mokweri/EmbedUno/README.md

# EmbedUno

A clone of Arduino Uno designed using Altium Designer as a learning project for PCB design.

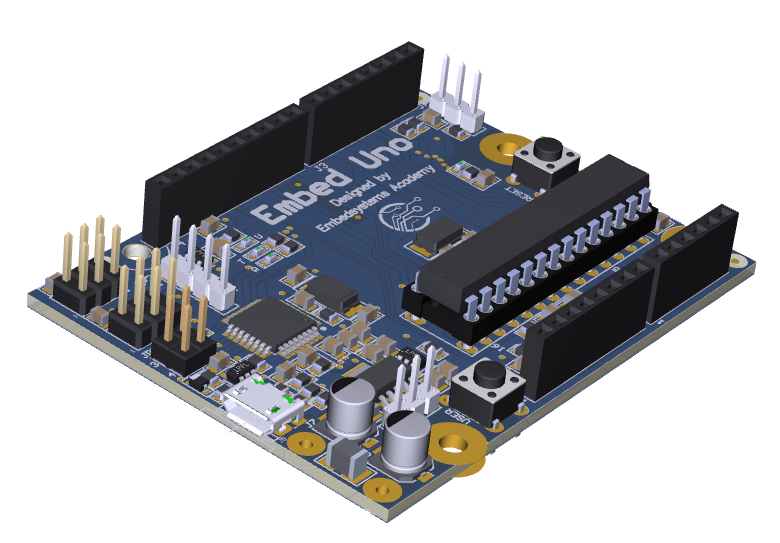
[picture p1: embeduno.PNG]


Designed in January 2020
