mokweri/EmbedUno/DesignFiles/EmbedUno_V1I1/embedsystems.png

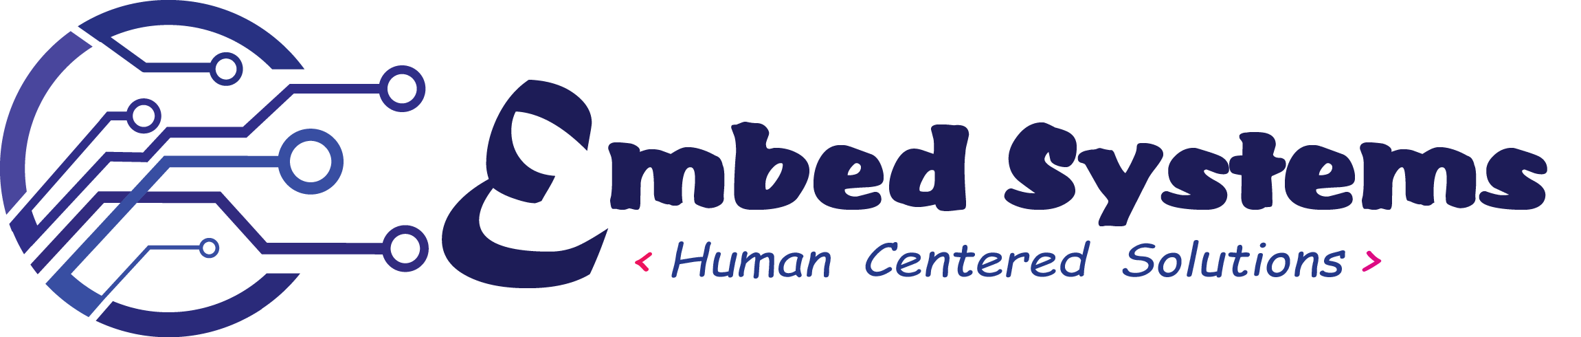
DesignFiles/EmbedUno_V1I1/embedsystems.png
