mokweri/EmbedUno/Fedevel Academy Cert.jpg

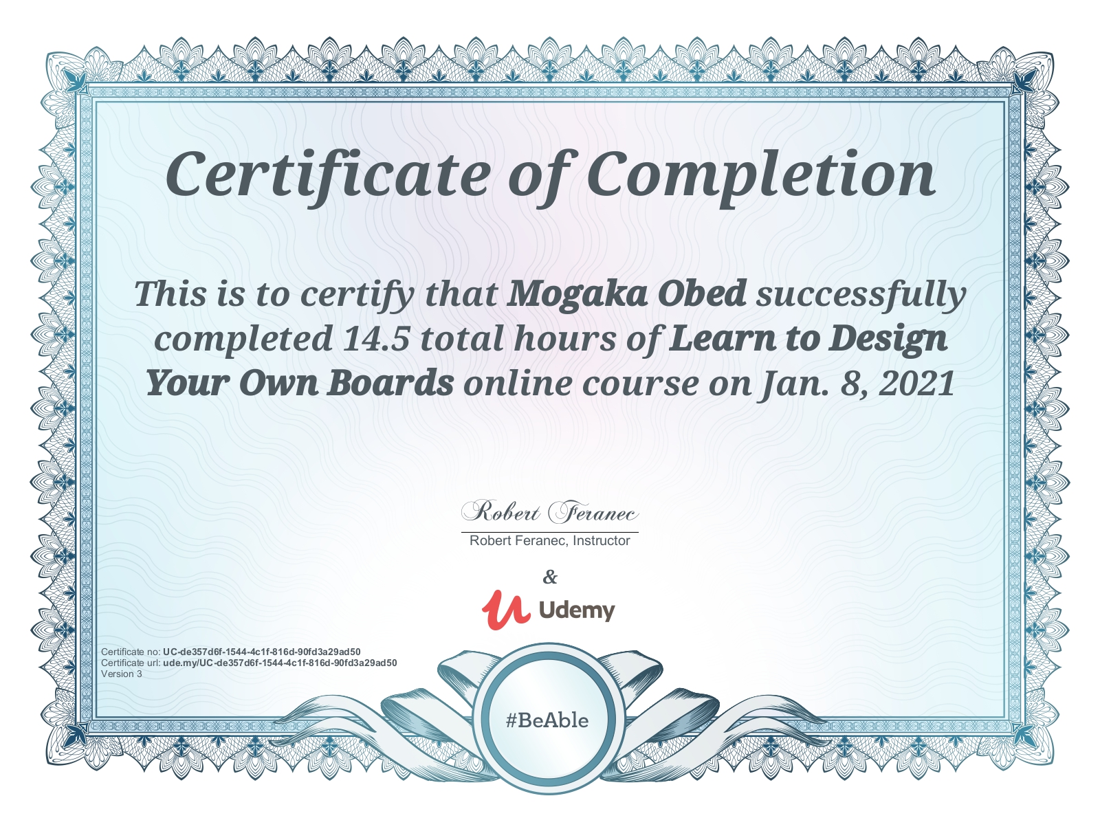
Fedevel Academy Cert.jpg
