mokweri/EmbedUno/!Released Files/Step 2 - Board Assembly/Variant 1 - EmbedUno V1I1 - Fixed 5V/BOM Purchasing - EmbedUno V1I1 - Fixed5V.xls

Sheet: Part List Report
 | Component list |  |  | EmbedUno BOM Purchasing for Variant [FIXED 5V] of Project [EmbedUno_V1I1.PrjPcb] (No PCB Document Selected)
 | Source Data From: | EmbedUno_V1I1.PrjPcb |  |  | Contact: |  |  |  | Generated by:
 | Project: | EmbedUno_V1I1.PrjPcb
 | Variant: | FIXED 5V |  |  |  |  |  |  | FEDEVEL
 | Report Date: | 08/01/2021 | 10:48 |  |  |  |  |  | http://www.fedevel.com
 | Print Date: | 2021-01-08 | 10:48:39
# | Category | Manufacturer 1 | Manufacturer Part Number 1 | #Column Name Error:' Package / Case | Description | Quantity | Supplier 1 | Supplier Part Number 1 | Supplier Order Qty 1 | Supplier Stock 1 | Supplier Unit Price 1 | Supplier Subtotal 1 | Supplier Currency 1
1 | Aluminum Electrolytic Capacitors | Panasonic | EEE-1AA101WR |  | Cap Aluminum 100uF 10V 20% (5 X 5.4mm) SMD 50mA 1000 hr 85°C T/R | 2 | Digi-Key | PCE3867CT-ND | 20 | 118060 | 0.24 | 4.86 | USD
2 | Ceramic Capacitors | TDK | C2012JB1E105K125AA |  | CAP CER 1UF 25V JB 0805 | 1 | Digi-Key | 445-11459-1-ND | 10 | 4257 | 0.14 | 1.39 | USD
3 | Ceramic Capacitors | TDK | C2012X5R1C106M085AC |  | TDK - C2012X5R1C106M085AC - SMD Multilayer Ceramic Capacitor, 10 µF, 16 V, 0805 [2012 Metric], ± 20%, X5R, C Series TDK | 7 | Digi-Key | 445-7645-1-ND | 70 | 160 | 0.11 | 7.97 | USD
4 | Ceramic Capacitors | KEMET | C0805C180J5GACTU |  | CAP CER 18PF 50V C0G/NP0 0805 | 4 | Digi-Key | 399-1112-1-ND | 40 | 98253 | 0.09 | 3.44 | USD
5 | Ceramic Capacitors | TDK | C2012X7R1H104M085AA |  | CAP CER 0.1UF 50V X7R 0805 | 19 | Digi-Key | 445-7535-1-ND | 190 | 7908 | 0.05 | 9.27 | USD
6 | Chip SMD Resistors | Yageo | RT0805FRE071KL |  | RES SMD 1K OHM 1% 1/8W 0805 | 3 | Digi-Key | YAG1240CT-ND | 30 | 45525 | 0.08 | 2.40 | USD
7 | Chip SMD Resistors | Yageo Phycomp | RC0805FR-071ML |  | RES SMD 1M OHM 1% 1/8W 0805 | 2 | Digi-Key | 311-1.00MCRCT-ND | 20 | 2401604 | 0.04 | 0.72 | USD
8 | Chip SMD Resistors | Yageo | AF0805FR-0710KL |  | Res SMD 10K Ohm 1% 1/8W 0805 | 6 | Digi-Key | 13-AF0805FR-0710KLCT-ND | 60 | 9580 | 0.09 | 5.16 | USD
9 | Chip SMD Resistors | Yageo | RC0805FR-0722RL |  | RES SMD 22 OHM 1% 1/8W 0805 | 7 | Digi-Key | 311-22.0CRCT-ND | 70 | 388180 | 0.04 | 2.52 | USD
10 | Chip SMD Resistors | Yageo | RT0805BRD07100KL |  | RES SMD 100K OHM 0.1% 1/8W 0805 | 1 | Digi-Key | YAG1759CT-ND | 10 | 6207 | 0.26 | 2.59 | USD
11 | Chip SMD Resistors | Yageo | RT0805FRE07560RL |  | RES SMD 560 OHM 1% 1/8W 0805 | 5 | Digi-Key | 13-RT0805FRE07560RLCT-ND | 50 | 9840 | 0.08 | 4.00 | USD
12 | Connectors | 3M | 4828-3004-CP |  | CONN IC DIP SOCKET 28POS TIN | 1 | Digi-Key | 3M5480-ND | 10 | 5 | 0.69 | 6.93 | USD
13 | Connectors | Sullins | QPC02SXGN-RC |  | CONN JUMPER SHORTING .100" GOLD | 2 | Digi-Key | S9337-ND | 20 | 698252 | 0.10 | 2.00 | USD
14 | Crystals | Abracon | ABM7-16.000MHZ-D2Y-T |  | CRYSTAL 16.0000MHZ 18PF SMD | 2 | Digi-Key | 535-9840-1-ND | 20 | 41060 | 0.77 | 15.46 | USD
15 | Ferrite Beads and Chips | TDK | MPZ2012S601AT000 |  | FERRITE BEAD 600 OHM 0805 1LN | 3 | Digi-Key | 445-2206-1-ND | 30 | 172425 | 0.08 | 2.47 | USD
16 | Fixed Inductors | KEMET | L1210R2R2MDWIT |  | FIXED IND 2.2UH 2A 80 MOHM SMD | 1 | Digi-Key | 399-9598-1-ND | 10 | 15053 | 0.42 | 4.17 | USD
17 | Headers and Wire Housings | Amphenol ICC | 68000-103HLF |  | HDR 1x3 | 1 | Digi-Key | 609-3461-ND | 10 | 21579 | 0.29 | 2.92 | USD
18 | Headers and Wire Housings | Amphenol FCI | 68001-204HLF |  | CONN HEADER VERT 4POS 2.54MM | 1 | Digi-Key | 609-3402-ND | 10 | 2119 | 0.36 | 3.57 | USD
19 | Headers and Wire Housings | Amphenol ICC / FCI | 67997-106HLF |  | CONN HEADER 6POS .100 STR 30AU | 2 | Digi-Key | 609-3393-ND | 20 | 1209 | 1.61 | 32.28 | USD
20 | Headers and Wire Housings | Harwin | M20-7820646 |  | HDR FEMALE 1x6 2.54mm | 1 | Digi-Key | 952-1809-ND | 10 | 1597 | 0.89 | 8.90 | USD
21 | Headers and Wire Housings | Harwin | M20-7820842 |  | 2.54mm (0.1") Pitch SIL Vertical PC Tail Socket Assembly, selective gold + tin, 8 contacts | 2 | Digi-Key | 952-1823-ND | 20 | 314 | 1.03 | 20.60 | USD
22 | Headers and Wire Housings | Harwin | M20-7821046 |  | HARWIN - M20-7821046 - Board-To-Board Connector, M20 Series, Through Hole, Receptacle, 10, 2.54 mm, Tin Plated Contacts | 1 | Digi-Key | 952-1847-ND | 10 | 645 | 1.00 | 9.97 | USD
23 | Logic Gates | Texas Instruments | SN74AHC1G09DBVR |  | TEXAS INSTRUMENTS - SN74AHC1G09DBVR - AND Gate, 74AHC1G09, 2 Input, 2 V to 5.5 V, SOT-23-5 | 4 | Digi-Key | 296-29202-1-ND | 40 | 14026 | 0.21 | 8.40 | USD
24 | Microcontrollers | Microchip / Atmel | ATMEGA16U2-AUR |  | IC MCU 8BIT 16KB FLASH 32TQFP | 1 | Digi-Key | ATMEGA16U2-AURCT-ND | 10 | 2980 | 2.52 | 25.20 | USD
25 | Microcontrollers | Microchip / Atmel | ATMEGA328P-PU |  | ATMEGA328P-PU; 8 bit Microcontroller AVR 20MHz 1; 32kb Flash; 2kb RAM; I2C SPI 2 | 1 | Digi-Key | ATMEGA328P-PU-ND | 10 | 9865 | 2.08 | 20.80 | USD
26 | Pushbutton Switches | ALCOSWITCH - TE CONNECTIVITY | 1825910-6 |  | SWITCH TACTILE SPST-NO 0.05A 24V | 2 | Digi-Key | 450-1650-ND | 20 | 131054 | 0.10 | 2.02 | USD
27 | Resistors | Yageo | RC0805JR-7W0RL |  | Resistor Thick Film Jumper 5% 0805 2-Pin Paper T/R | 2 | Digi-Key | 13-RC0805JR-7W0RLCT-ND | 20 | 3085 | 0.06 | 1.12 | USD
28 | Schottky Diodes | ON Semiconductor / Fairchild | BAT54HT1G |  | Small Signal Schottky Diode, Single, 30 V, 200 mA, 800 mV, 600 mA, 150 C ;RoHS Compliant: Yes | 2 | Digi-Key | BAT54HT1GOSCT-ND | 20 | 289270 | 0.14 | 2.82 | USD
29 | Uncategorized | Osram Opto | LGL29K-G2J1-24-Z |  | LED Uni-Color Green 572nm 2-Pin Chip 0603(1608Metric) T/R | 1 | Digi-Key | 475-2709-1-ND | 10 | 125735 | 0.31 | 3.08 | USD
30 | Uncategorized | Osram Opto | LOL29K-H2K1-24-Z |  | OSRAM - LO L29K-H2K1-24-Z - SMARTLED 0603 ORANGE | 3 | Digi-Key | 475-2740-2-ND |  | 0
31 | USB Connectors | AMPHENOL ICC (FCI) | 10118193-0001LF |  | CONN USB MICRO B RECPT SMT R/A | 1 | Digi-Key | 609-4616-1-ND | 10 | 42513 | 0.45 | 4.51 | USD
32 | Varistors | Bourns | CG0603MLC-05E |  | VARISTOR 0603 | 2 | Digi-Key | CG0603MLC-05ECT-ND | 20 | 110653 | 0.35 | 6.96 | USD
33 | Voltage Regulators - Linear | Texas Instruments | TL1963A-33DCQR |  | IC REG LINEAR 3.3V 1.5A SOT223-6 | 1 | Digi-Key | 296-24534-1-ND | 10 | 1730 | 2.51 | 25.13 | USD
 |  |  |  |  |  | 94 |  |  | 910 |  |  | 253.63
Approved |  |  |  | Notes
 |  |  |  |  |  | 10 | pcs: | Total |  | 253.63 |  | USD
 |  |  |  |  |  |  |  | Price for 1pcs |  | 25.36 |  | USD

Sheet: Project Information
Project Full Path | C:\Users\OBED\Documents\EmbedUno\DesignFiles\EmbedUno_V1I1\EmbedUno_V1I1.PrjPcb
Project Filename | EmbedUno_V1I1.PrjPcb
Variant Name | FIXED 5V
Data-Source Filename | EmbedUno_V1I1.PrjPcb
Data-Source Full Path | C:\Users\OBED\Documents\EmbedUno\DesignFiles\EmbedUno_V1I1\EmbedUno_V1I1.PrjPcb
Title | EmbedUno BOM Purchasing for Variant [FIXED 5V] of Project [EmbedUno_V1I1.PrjPcb] (No PCB Document Selected)
Total Quantity | 94
Report Time | 10:48
Report Date | 08/01/2021
Report Date & Tine | 08/01/2021 10:48
Output Name | EmbedUno BOM Purchasing
Output Type | BOM_PartType
Output Generator Name | BOM
Output Generator Description | Bill of Materials
