mokweri/EmbedUno/!Released Files/Step 2 - Board Assembly/Variant 1 - EmbedUno V1I1 - Fixed 5V/Componed Reference grouped BOM-EmbedUno_V1I1(FIXED 5V).xls

Sheet: Part List Report
 | Component reference list (grouped) |  |  |  | EmbedUno
 | Source Data From: |  | EmbedUno_V1I1.PrjPcb |  |  | Contact: |  | Generated by:
 | Project: |  | EmbedUno_V1I1.PrjPcb
 | Variant: |  | FIXED 5V |  |  |  |  | FEDEVEL
 | Report Date: |  | 08/01/2021 | 11:20 |  |  |  | http://www.fedevel.com
 | Print Date: |  | 2021-01-08 | 11:21:07
# | Designator | Quantity | Comment | Description | Manufacturer 1 | Manufacturer Part Number 1 | #Column Name Error:' Package / Case | Supplier 1 | Supplier Part Number 1
1 | C1, C2 | 2 | 100uF/10V | Cap Aluminum 100uF 10V 20% (5 X 5.4mm) SMD 50mA 1000 hr 85°C T/R |  |  |  | Digi-Key | PCE3867CT-ND
2 | C3, C12, C13, C19, C21, C22, C34 | 7 | 10uF/16V | TDK - C2012X5R1C106M085AC - SMD Multilayer Ceramic Capacitor, 10 µF, 16 V, 0805 [2012 Metric], ± 20%, X5R, C Series TDK |  |  |  | Digi-Key | 445-7645-1-ND
3 | C4, C5, C6, C8, C11, C14, C15, C16, C17, C20, C23, C24, C26, C28, C29, C30, C31, C32, C33 | 19 | 100n | CAP CER 0.1UF 50V X7R 0805 |  |  |  | Digi-Key | 445-7535-1-ND
4 | C7 | 1 | 1uF/25V | CAP CER 1UF 25V JB 0805 |  |  |  | Digi-Key | 445-11459-1-ND
5 | C9, C10, C25, C27 | 4 | 18p | CAP CER 18PF 50V C0G/NP0 0805 |  |  |  | Digi-Key | 399-1112-1-ND
6 | D1 | 1 | GREEN | LED Uni-Color Green 572nm 2-Pin Chip 0603(1608Metric) T/R |  |  |  | Digi-Key | 475-2709-1-ND
7 | D2, D3, D4 | 3 | Orange | OSRAM - LO L29K-H2K1-24-Z - SMARTLED 0603 ORANGE |  |  |  | Digi-Key | 475-2740-2-ND
8 | D5, D6 | 2 | BAT54HT1G | Small Signal Schottky Diode, Single, 30 V, 200 mA, 800 mV, 600 mA, 150 C ;RoHS Compliant: Yes |  |  |  | Digi-Key | BAT54HT1GOSCT-ND
9 | FB1, FB2, FB3 | 3 | MPZ2012S601AT000 | FERRITE BEAD 600 OHM 0805 1LN |  |  |  | Digi-Key | 445-2206-1-ND
10 | J1, J3 | 2 | HDR FEMALE 1x8 2.54mm | 2.54mm (0.1") Pitch SIL Vertical PC Tail Socket Assembly, selective gold + tin, 8 contacts |  |  |  | Digi-Key | 952-1823-ND
11 | J2 | 1 | HDR FEMALE 1x6 2.54mm | HDR FEMALE 1x6 2.54mm |  |  |  | Digi-Key | 952-1809-ND
12 | J4 | 1 | HDR FEMALE 1x10 2.54mm | HARWIN - M20-7821046 - Board-To-Board Connector, M20 Series, Through Hole, Receptacle, 10, 2.54 mm, Tin Plated Contacts |  |  |  | Digi-Key | 952-1847-ND
13 | J5, J6 | 2 | HDR 2x3 | CONN HEADER 6POS .100 STR 30AU |  |  |  | Digi-Key | 609-3393-ND
14 | J7 | 1 | 10118193-0001LF | CONN USB MICRO B RECPT SMT R/A |  |  |  | Digi-Key | 609-4616-1-ND
15 | JP1 | 1 | HDR 1x3 | HDR 1x3 |  |  |  | Digi-Key | 609-3461-ND
16 | JP3 | 1 | HDR 1x4 | CONN HEADER VERT 4POS 2.54MM |  |  |  | Digi-Key | 609-3402-ND
17 | L1 | 1 | 2u2/2A | FIXED IND 2.2UH 2A 80 MOHM SMD |  |  |  | Digi-Key | 399-9598-1-ND
18 | LINK1, LINK2 | 2 | LINK | CONN JUMPER SHORTING .100" GOLD |  |  |  | Digi-Key | S9337-ND
19 | R1 | 1 | 100K | RES SMD 100K OHM 0.1% 1/8W 0805 |  |  |  | Digi-Key | YAG1759CT-ND
20 | R2, R3, R15, R17, R22 | 5 | 560R | RES SMD 560 OHM 1% 1/8W 0805 |  |  |  | Digi-Key | 13-RT0805FRE07560RLCT-ND
21 | R4, R14, R18, R19, R20, R21 | 6 | 10K | Res SMD 10K Ohm 1% 1/8W 0805 |  |  |  | Digi-Key | 13-AF0805FR-0710KLCT-ND
22 | R5, R6, R7, R13, R23, R24, R25 | 7 | 22R | RES SMD 22 OHM 1% 1/8W 0805 |  |  |  | Digi-Key | 311-22.0CRCT-ND
23 | R8, R27 | 2 | 0R | Resistor Thick Film Jumper 5% 0805 2-Pin Paper T/R |  |  |  | Digi-Key | 13-RC0805JR-7W0RLCT-ND
24 | R9, R16 | 2 | 1M | RES SMD 1M OHM 1% 1/8W 0805 |  |  |  | Digi-Key | 311-1.00MCRCT-ND
25 | R10, R11, R12 | 3 | 1K | RES SMD 1K OHM 1% 1/8W 0805 |  |  |  | Digi-Key | YAG1240CT-ND
26 | SCK FOR U1 | 1 | 28-DIP Socket | CONN IC DIP SOCKET 28POS TIN |  |  |  | Digi-Key | 3M5480-ND
27 | SW1, SW2 | 2 | 1825910-6 | SWITCH TACTILE SPST-NO 0.05A 24V |  |  |  | Digi-Key | 450-1650-ND
28 | U1 | 1 | ATMEGA16U2-AUR | IC MCU 8BIT 16KB FLASH 32TQFP |  |  |  | Digi-Key | ATMEGA16U2-AURCT-ND
29 | U2 | 1 | TL1963A-33DCQR | IC REG LINEAR 3.3V 1.5A SOT223-6 |  |  |  | Digi-Key | 296-24534-1-ND
30 | U3 | 1 | ATMEGA328P-PU | ATMEGA328P-PU; 8 bit Microcontroller AVR 20MHz 1; 32kb Flash; 2kb RAM; I2C SPI 2 |  |  |  | Digi-Key | ATMEGA328P-PU-ND
31 | U4, U5, U6, U7 | 4 | SN74AHC1G09DBVR | TEXAS INSTRUMENTS - SN74AHC1G09DBVR - AND Gate, 74AHC1G09, 2 Input, 2 V to 5.5 V, SOT-23-5 |  |  |  | Digi-Key | 296-29202-1-ND
32 | Y1, Y2 | 2 | ABM7-16.000MHZ-D2Y-T | CRYSTAL 16.0000MHZ 18PF SMD |  |  |  | Digi-Key | 535-9840-1-ND
33 | Z1, Z2 | 2 | CG0603MLC-05E | VARISTOR 0603 |  |  |  | Digi-Key | CG0603MLC-05ECT-ND
Approved |  |  |  |  | Notes

Sheet: Project Information
Project Full Path | C:\Users\OBED\Documents\EmbedUno\DesignFiles\EmbedUno_V1I1\EmbedUno_V1I1.PrjPcb
Project Filename | EmbedUno_V1I1.PrjPcb
Variant Name | FIXED 5V
Data-Source Filename | EmbedUno_V1I1.PrjPcb
Data-Source Full Path | C:\Users\OBED\Documents\EmbedUno\DesignFiles\EmbedUno_V1I1\EmbedUno_V1I1.PrjPcb
Title | EmbedUno_V1I1.PrjPcb
Total Quantity | 94
Report Time | 11:20
Report Date | 08/01/2021
Report Date & Tine | 08/01/2021 11:20
Output Name | Embeduno Componed Reference grouped BOM
Output Type | BOM_PartType
Output Generator Name | BOM
Output Generator Description | Bill of Materials
