mokweri/EmbedUno/!Released Files/Step 2 - Board Assembly/Variant 2 - EmbedUno V1I1 - 5V and 3V3/BOM Reference - EmbedUno_V1I1(5V_3V3).xlsx

Sheet: Part List Report
 | Component reference list |  |  | EmbedUno
 |  | Source Data From: | EmbedUno_V1I1.PrjPcb |  | Contact: |  | Generated by:
 |  | Project: | EmbedUno_V1I1.PrjPcb
 |  | Variant: | 5V/3V3 |  |  |  | FEDEVEL
 | Report Date: | 08/01/2021 | 11:09 |  |  |  | http://www.fedevel.com
 | Print Date: | 2021-01-08 | 11:09:59
# | Designator | Comment | Description | Manufacturer 1 | Manufacturer Part Number 1 | Case/Package | Supplier 1 | Supplier Part Number 1
1 | C1 | 100uF/10V | Cap Aluminum 100uF 10V 20% (5 X 5.4mm) SMD 50mA 1000 hr 85°C T/R |  |  | Radial | Digi-Key | PCE3867CT-ND
2 | C2 | 100uF/10V | Cap Aluminum 100uF 10V 20% (5 X 5.4mm) SMD 50mA 1000 hr 85°C T/R |  |  | Radial | Digi-Key | PCE3867CT-ND
3 | C3 | 10uF/16V | TDK - C2012X5R1C106M085AC - SMD Multilayer Ceramic Capacitor, 10 µF, 16 V, 0805 [2012 Metric], ± 20%, X5R, C Series TDK |  |  | 805 | Digi-Key | 445-7645-1-ND
4 | C4 | 100n | CAP CER 0.1UF 50V X7R 0805 |  |  | 805 | Digi-Key | 445-7535-1-ND
5 | C5 | 100n | CAP CER 0.1UF 50V X7R 0805 |  |  | 805 | Digi-Key | 445-7535-1-ND
6 | C6 | 100n | CAP CER 0.1UF 50V X7R 0805 |  |  | 805 | Digi-Key | 445-7535-1-ND
7 | C7 | 1uF/25V | CAP CER 1UF 25V JB 0805 |  |  | 805 | Digi-Key | 445-11459-1-ND
8 | C8 | 100n | CAP CER 0.1UF 50V X7R 0805 |  |  | 805 | Digi-Key | 445-7535-1-ND
9 | C9 | 18p | CAP CER 18PF 50V C0G/NP0 0805 |  |  | 805 | Digi-Key | 399-1112-1-ND
10 | C10 | 18p | CAP CER 18PF 50V C0G/NP0 0805 |  |  | 805 | Digi-Key | 399-1112-1-ND
11 | C11 | 100n | CAP CER 0.1UF 50V X7R 0805 |  |  | 805 | Digi-Key | 445-7535-1-ND
12 | C12 | 10uF/16V | TDK - C2012X5R1C106M085AC - SMD Multilayer Ceramic Capacitor, 10 µF, 16 V, 0805 [2012 Metric], ± 20%, X5R, C Series TDK |  |  | 805 | Digi-Key | 445-7645-1-ND
13 | C13 | 10uF/16V | TDK - C2012X5R1C106M085AC - SMD Multilayer Ceramic Capacitor, 10 µF, 16 V, 0805 [2012 Metric], ± 20%, X5R, C Series TDK |  |  | 805 | Digi-Key | 445-7645-1-ND
14 | C14 | 100n | CAP CER 0.1UF 50V X7R 0805 |  |  | 805 | Digi-Key | 445-7535-1-ND
15 | C15 | 100n | CAP CER 0.1UF 50V X7R 0805 |  |  | 805 | Digi-Key | 445-7535-1-ND
16 | C16 | 100n | CAP CER 0.1UF 50V X7R 0805 |  |  | 805 | Digi-Key | 445-7535-1-ND
17 | C17 | 100n | CAP CER 0.1UF 50V X7R 0805 |  |  | 805 | Digi-Key | 445-7535-1-ND
18 | C19 | 10uF/16V | TDK - C2012X5R1C106M085AC - SMD Multilayer Ceramic Capacitor, 10 µF, 16 V, 0805 [2012 Metric], ± 20%, X5R, C Series TDK |  |  | 805 | Digi-Key | 445-7645-1-ND
19 | C20 | 100n | CAP CER 0.1UF 50V X7R 0805 |  |  | 805 | Digi-Key | 445-7535-1-ND
20 | C21 | 10uF/16V | TDK - C2012X5R1C106M085AC - SMD Multilayer Ceramic Capacitor, 10 µF, 16 V, 0805 [2012 Metric], ± 20%, X5R, C Series TDK |  |  | 805 | Digi-Key | 445-7645-1-ND
21 | C22 | 10uF/16V | TDK - C2012X5R1C106M085AC - SMD Multilayer Ceramic Capacitor, 10 µF, 16 V, 0805 [2012 Metric], ± 20%, X5R, C Series TDK |  |  | 805 | Digi-Key | 445-7645-1-ND
22 | C23 | 100n | CAP CER 0.1UF 50V X7R 0805 |  |  | 805 | Digi-Key | 445-7535-1-ND
23 | C24 | 100n | CAP CER 0.1UF 50V X7R 0805 |  |  | 805 | Digi-Key | 445-7535-1-ND
24 | C25 | 18p | CAP CER 18PF 50V C0G/NP0 0805 |  |  | 805 | Digi-Key | 399-1112-1-ND
25 | C26 | 100n | CAP CER 0.1UF 50V X7R 0805 |  |  | 805 | Digi-Key | 445-7535-1-ND
26 | C27 | 18p | CAP CER 18PF 50V C0G/NP0 0805 |  |  | 805 | Digi-Key | 399-1112-1-ND
27 | C28 | 100n | CAP CER 0.1UF 50V X7R 0805 |  |  | 805 | Digi-Key | 445-7535-1-ND
28 | C29 | 100n | CAP CER 0.1UF 50V X7R 0805 |  |  | 805 | Digi-Key | 445-7535-1-ND
29 | C30 | 100n | CAP CER 0.1UF 50V X7R 0805 |  |  | 805 | Digi-Key | 445-7535-1-ND
30 | C31 | 100n | CAP CER 0.1UF 50V X7R 0805 |  |  | 805 | Digi-Key | 445-7535-1-ND
31 | C32 | 100n | CAP CER 0.1UF 50V X7R 0805 |  |  | 805 | Digi-Key | 445-7535-1-ND
32 | C33 | 100n | CAP CER 0.1UF 50V X7R 0805 |  |  | 805 | Digi-Key | 445-7535-1-ND
33 | C34 | 10uF/16V | TDK - C2012X5R1C106M085AC - SMD Multilayer Ceramic Capacitor, 10 µF, 16 V, 0805 [2012 Metric], ± 20%, X5R, C Series TDK |  |  | 805 | Digi-Key | 445-7645-1-ND
34 | D1 | GREEN | LED Uni-Color Green 572nm 2-Pin Chip 0603(1608Metric) T/R |  |  | 603 | Digi-Key | 475-2709-1-ND
35 | D2 | Orange | OSRAM - LO L29K-H2K1-24-Z - SMARTLED 0603 ORANGE |  |  | 603 | Digi-Key | 475-2740-2-ND
36 | D3 | Orange | OSRAM - LO L29K-H2K1-24-Z - SMARTLED 0603 ORANGE |  |  | 603 | Digi-Key | 475-2740-2-ND
37 | D4 | Orange | OSRAM - LO L29K-H2K1-24-Z - SMARTLED 0603 ORANGE |  |  | 603 | Digi-Key | 475-2740-2-ND
38 | D5 | BAT54HT1G | Small Signal Schottky Diode, Single, 30 V, 200 mA, 800 mV, 600 mA, 150 C ;RoHS Compliant: Yes |  |  |  | Digi-Key | BAT54HT1GOSCT-ND
39 | D6 | BAT54HT1G | Small Signal Schottky Diode, Single, 30 V, 200 mA, 800 mV, 600 mA, 150 C ;RoHS Compliant: Yes |  |  |  | Digi-Key | BAT54HT1GOSCT-ND
40 | FB1 | MPZ2012S601AT000 | FERRITE BEAD 600 OHM 0805 1LN |  |  | 805 | Digi-Key | 445-2206-1-ND
41 | FB2 | MPZ2012S601AT000 | FERRITE BEAD 600 OHM 0805 1LN |  |  | 805 | Digi-Key | 445-2206-1-ND
42 | FB3 | MPZ2012S601AT000 | FERRITE BEAD 600 OHM 0805 1LN |  |  | 805 | Digi-Key | 445-2206-1-ND
43 | J1 | HDR FEMALE 1x8 2.54mm | 2.54mm (0.1") Pitch SIL Vertical PC Tail Socket Assembly, selective gold + tin, 8 contacts |  |  | SIL | Digi-Key | 952-1823-ND
44 | J2 | HDR FEMALE 1x6 2.54mm | HDR FEMALE 1x6 2.54mm |  |  | SIL | Digi-Key | 952-1809-ND
45 | J3 | HDR FEMALE 1x8 2.54mm | 2.54mm (0.1") Pitch SIL Vertical PC Tail Socket Assembly, selective gold + tin, 8 contacts |  |  | SIL | Digi-Key | 952-1823-ND
46 | J4 | HDR FEMALE 1x10 2.54mm | HARWIN - M20-7821046 - Board-To-Board Connector, M20 Series, Through Hole, Receptacle, 10, 2.54 mm, Tin Plated Contacts |  |  | SIL | Digi-Key | 952-1847-ND
47 | J5 | HDR 2x3 | CONN HEADER 6POS .100 STR 30AU |  |  |  | Digi-Key | 609-3393-ND
48 | J6 | HDR 2x3 | CONN HEADER 6POS .100 STR 30AU |  |  |  | Digi-Key | 609-3393-ND
49 | J7 | 10118193-0001LF | CONN USB MICRO B RECPT SMT R/A |  |  |  | Digi-Key | 609-4616-1-ND
50 | JP1 | HDR 1x3 | HDR 1x3 |  |  |  | Digi-Key | 609-3461-ND
51 | JP3 | HDR 1x4 | CONN HEADER VERT 4POS 2.54MM |  |  |  | Digi-Key | 609-3402-ND
52 | JP4 | HDR 1x3 | HDR 1x3 |  |  |  | Digi-Key | 609-3461-ND
53 | L1 | 2u2/2A | FIXED IND 2.2UH 2A 80 MOHM SMD |  |  | 1210 | Digi-Key | 399-9598-1-ND
54 | LINK1 | LINK | CONN JUMPER SHORTING .100" GOLD |  |  | 100 | Digi-Key | S9337-ND
55 | LINK2 | LINK | CONN JUMPER SHORTING .100" GOLD |  |  | 100 | Digi-Key | S9337-ND
56 | LINK3 | LINK | CONN JUMPER SHORTING .100" GOLD |  |  | 100 | Digi-Key | S9337-ND
57 | R1 | 100K | RES SMD 100K OHM 0.1% 1/8W 0805 |  |  | 805 | Digi-Key | YAG1759CT-ND
58 | R2 | 560R | RES SMD 560 OHM 1% 1/8W 0805 |  |  | 805 | Digi-Key | 13-RT0805FRE07560RLCT-ND
59 | R3 | 560R | RES SMD 560 OHM 1% 1/8W 0805 |  |  | 805 | Digi-Key | 13-RT0805FRE07560RLCT-ND
60 | R4 | 10K | Res SMD 10K Ohm 1% 1/8W 0805 |  |  | 805 | Digi-Key | 13-AF0805FR-0710KLCT-ND
61 | R5 | 22R | RES SMD 22 OHM 1% 1/8W 0805 |  |  | 805 | Digi-Key | 311-22.0CRCT-ND
62 | R6 | 22R | RES SMD 22 OHM 1% 1/8W 0805 |  |  | 805 | Digi-Key | 311-22.0CRCT-ND
63 | R7 | 22R | RES SMD 22 OHM 1% 1/8W 0805 |  |  | 805 | Digi-Key | 311-22.0CRCT-ND
64 | R8 | 0R | Resistor Thick Film Jumper 5% 0805 2-Pin Paper T/R |  |  |  | Digi-Key | 13-RC0805JR-7W0RLCT-ND
65 | R9 | 1M | RES SMD 1M OHM 1% 1/8W 0805 |  |  | 805 | Digi-Key | 311-1.00MCRCT-ND
66 | R10 | 1K | RES SMD 1K OHM 1% 1/8W 0805 |  |  | 805 | Digi-Key | YAG1240CT-ND
67 | R11 | 1K | RES SMD 1K OHM 1% 1/8W 0805 |  |  | 805 | Digi-Key | YAG1240CT-ND
68 | R12 | 1K | RES SMD 1K OHM 1% 1/8W 0805 |  |  | 805 | Digi-Key | YAG1240CT-ND
69 | R13 | 22R | RES SMD 22 OHM 1% 1/8W 0805 |  |  | 805 | Digi-Key | 311-22.0CRCT-ND
70 | R14 | 10K | Res SMD 10K Ohm 1% 1/8W 0805 |  |  | 805 | Digi-Key | 13-AF0805FR-0710KLCT-ND
71 | R15 | 560R | RES SMD 560 OHM 1% 1/8W 0805 |  |  | 805 | Digi-Key | 13-RT0805FRE07560RLCT-ND
72 | R16 | 1M | RES SMD 1M OHM 1% 1/8W 0805 |  |  | 805 | Digi-Key | 311-1.00MCRCT-ND
73 | R17 | 560R | RES SMD 560 OHM 1% 1/8W 0805 |  |  | 805 | Digi-Key | 13-RT0805FRE07560RLCT-ND
74 | R18 | 10K | Res SMD 10K Ohm 1% 1/8W 0805 |  |  | 805 | Digi-Key | 13-AF0805FR-0710KLCT-ND
75 | R19 | 10K | Res SMD 10K Ohm 1% 1/8W 0805 |  |  | 805 | Digi-Key | 13-AF0805FR-0710KLCT-ND
76 | R20 | 10K | Res SMD 10K Ohm 1% 1/8W 0805 |  |  | 805 | Digi-Key | 13-AF0805FR-0710KLCT-ND
77 | R21 | 10K | Res SMD 10K Ohm 1% 1/8W 0805 |  |  | 805 | Digi-Key | 13-AF0805FR-0710KLCT-ND
78 | R22 | 560R | RES SMD 560 OHM 1% 1/8W 0805 |  |  | 805 | Digi-Key | 13-RT0805FRE07560RLCT-ND
79 | R23 | 22R | RES SMD 22 OHM 1% 1/8W 0805 |  |  | 805 | Digi-Key | 311-22.0CRCT-ND
80 | R24 | 22R | RES SMD 22 OHM 1% 1/8W 0805 |  |  | 805 | Digi-Key | 311-22.0CRCT-ND
81 | R25 | 22R | RES SMD 22 OHM 1% 1/8W 0805 |  |  | 805 | Digi-Key | 311-22.0CRCT-ND
82 | SCK FOR U1 | 28-DIP Socket | CONN IC DIP SOCKET 28POS TIN |  |  |  | Digi-Key | 3M5480-ND
83 | SW1 | 1825910-6 | SWITCH TACTILE SPST-NO 0.05A 24V |  |  |  | Digi-Key | 450-1650-ND
84 | SW2 | 1825910-6 | SWITCH TACTILE SPST-NO 0.05A 24V |  |  |  | Digi-Key | 450-1650-ND
85 | U1 | ATMEGA16U2-AUR | IC MCU 8BIT 16KB FLASH 32TQFP |  |  | LQFP | Digi-Key | ATMEGA16U2-AURCT-ND
86 | U2 | TL1963A-33DCQR | IC REG LINEAR 3.3V 1.5A SOT223-6 |  |  | SOT-223 | Digi-Key | 296-24534-1-ND
87 | U3 | ATMEGA328P-PU | ATMEGA328P-PU; 8 bit Microcontroller AVR 20MHz 1; 32kb Flash; 2kb RAM; I2C SPI 2 |  |  | PDIP | Digi-Key | ATMEGA328P-PU-ND
88 | U4 | SN74AHC1G09DBVR | TEXAS INSTRUMENTS - SN74AHC1G09DBVR - AND Gate, 74AHC1G09, 2 Input, 2 V to 5.5 V, SOT-23-5 |  |  | SOT-23 | Digi-Key | 296-29202-1-ND
89 | U5 | SN74AHC1G09DBVR | TEXAS INSTRUMENTS - SN74AHC1G09DBVR - AND Gate, 74AHC1G09, 2 Input, 2 V to 5.5 V, SOT-23-5 |  |  | SOT-23 | Digi-Key | 296-29202-1-ND
90 | U6 | SN74AHC1G09DBVR | TEXAS INSTRUMENTS - SN74AHC1G09DBVR - AND Gate, 74AHC1G09, 2 Input, 2 V to 5.5 V, SOT-23-5 |  |  | SOT-23 | Digi-Key | 296-29202-1-ND
91 | U7 | SN74AHC1G09DBVR | TEXAS INSTRUMENTS - SN74AHC1G09DBVR - AND Gate, 74AHC1G09, 2 Input, 2 V to 5.5 V, SOT-23-5 |  |  | SOT-23 | Digi-Key | 296-29202-1-ND
92 | Y1 | ABM7-10.000MHZ-D2Y-T | CRYSTAL 10.0000MHZ 18PF SMD |  |  | SMD/SMT | Digi-Key | 535-9833-1-ND
93 | Y2 | ABM7-8.000MHZ-D2Y-T | ABRACON - ABM7-8.000MHZ-D2Y-T - Crystal, Miniature, 8 MHz, SMD, 6mm x 3.5mm, 30 ppm, 18 pF, 20 ppm, ABM7 Series |  |  | CSMD | Digi-Key | 535-9831-1-ND
94 | Z1 | CG0603MLC-05E | VARISTOR 0603 |  |  | 603 | Digi-Key | CG0603MLC-05ECT-ND
95 | Z2 | CG0603MLC-05E | VARISTOR 0603 |  |  | 603 | Digi-Key | CG0603MLC-05ECT-ND
Approved |  |  |  | Notes

Sheet: Project Information
Project Full Path | C:\Users\OBED\Documents\EmbedUno\DesignFiles\EmbedUno_V1I1\EmbedUno_V1I1.PrjPcb
Project Filename | EmbedUno_V1I1.PrjPcb
Variant Name | 5V/3V3
Data-Source Filename | EmbedUno_V1I1.PrjPcb
Data-Source Full Path | C:\Users\OBED\Documents\EmbedUno\DesignFiles\EmbedUno_V1I1\EmbedUno_V1I1.PrjPcb
Title | EmbedUno_V1I1.PrjPcb
Total Quantity | 95
Report Time | 11:09
Report Date | 08/01/2021
Report Date & Tine | 08/01/2021 11:09
Output Name | EmbedUno Reference BOM
Output Type | BOM_PartType
Output Generator Name | BOM
Output Generator Description | Bill of Materials
