mokweri/EmbedUno/Templates/Templates/BOM/BOM Reference FEDEVEL.xlsx

Sheet: Part List Report
 | Component reference list |  |  | Field=Project
 |  | Source Data From: | Field=DataSourceFileName |  | Contact: |  | Generated by:
 |  | Project: | Field=ProjectFileName
 |  | Variant: | Field=VariantName |  |  |  | FEDEVEL
 | Report Date: | Field=ReportDate | Field=ReportTime |  |  |  | http://www.fedevel.com
 | Print Date: | 2021-01-08 | 11:06:49
# | Column=Designator | Column=Comment | Column=Description | Column=Manufacturer 1 | Column=Manufacturer Part Number 1 | Column=Case/Package | Column=Supplier 1 | Column=Supplier Part Number 1
1
2
3
Approved |  |  |  | Notes

Sheet: Project Information
Project Full Path | Field=ProjectFullPath
Project Filename | Field=ProjectFileName
Variant Name | Field=VariantName
Data-Source Filename | Field=DataSourceFileName
Data-Source Full Path | Field=DataSourceFullPath
Title | Field=ProjectFileName
Total Quantity | Field=TotalQuantity
Report Time | Field=ReportTime
Report Date | Field=ReportDate
Report Date & Tine | Field=ReportDateTime
Output Name | Field=OutputName
Output Type | Field=OutputType
Output Generator Name | Field=GeneratorName
Output Generator Description | Field=GeneratorDescription
