mokweri/EmbedUno/3D Files/Header1x2.STEP

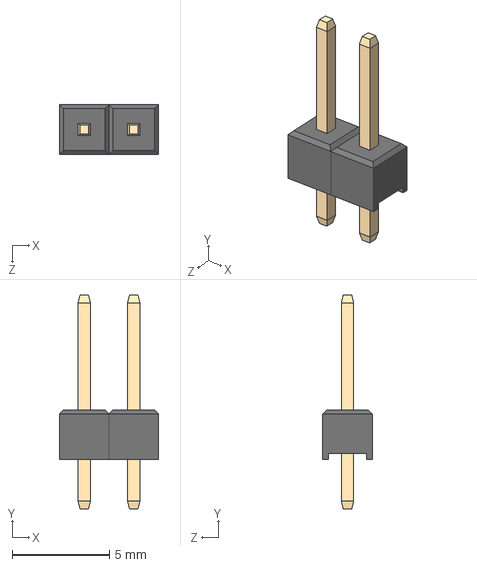
[picture p4: CAD file, 2021-01-07]
3D Files/Header1x2.STEP
5.08 x 11.0 x 2.54 mm
Header1_1 x 2
