mokweri/EmbedUno/3D Files/R0603.step

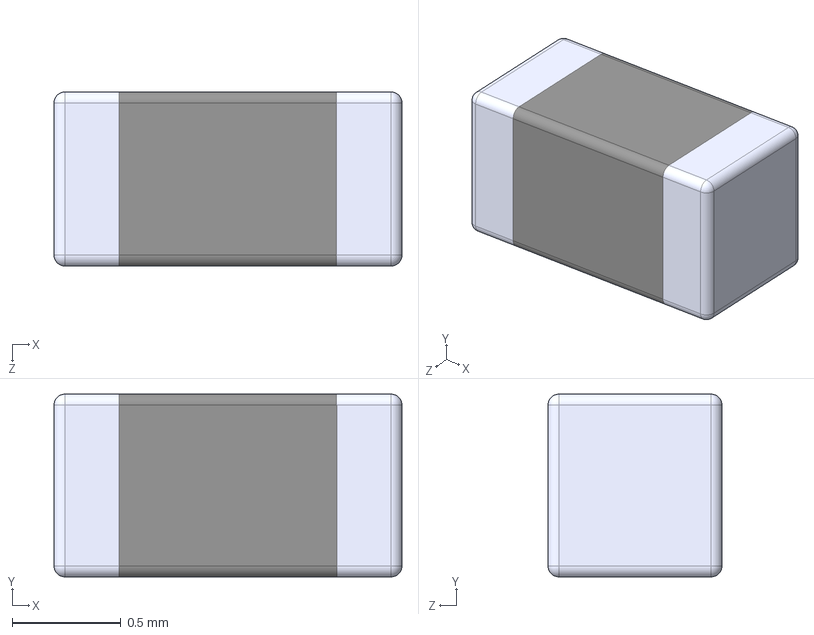
[picture p5: CAD file, 2021-01-07]
3D Files/R0603.step
1.60 x 0.84 x 0.8 mm
