mokweri/EmbedUno/3D Files/User Library-SOD323-1.step

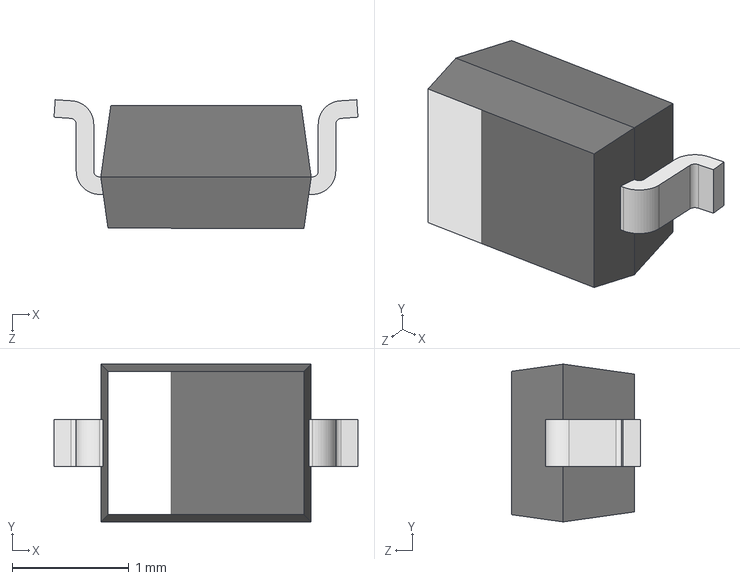
[picture p6: CAD file, 2021-01-07]
3D Files/User Library-SOD323-1.step
2.60 x 1.35 x 1.10 mm
