mokweri/EmbedUno/3D Files/User Library-Chip Resistor2.step

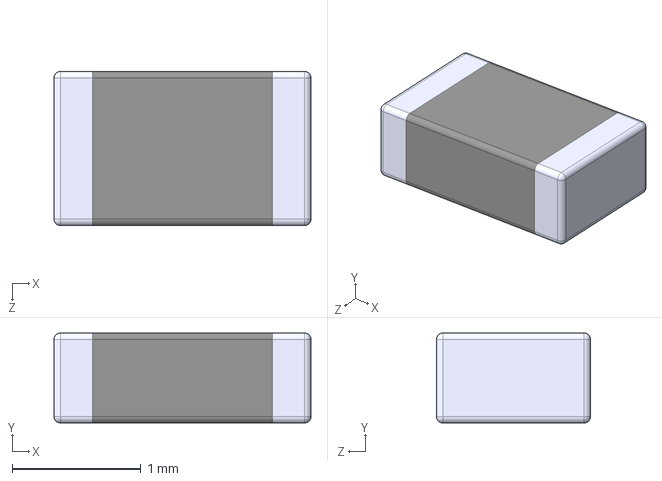
[picture p7: CAD file, 2021-01-07]
3D Files/User Library-Chip Resistor2.step
2.00 x 0.7 x 1.20 mm
