mokweri/EmbedUno/3D Files/hdr2x3.step

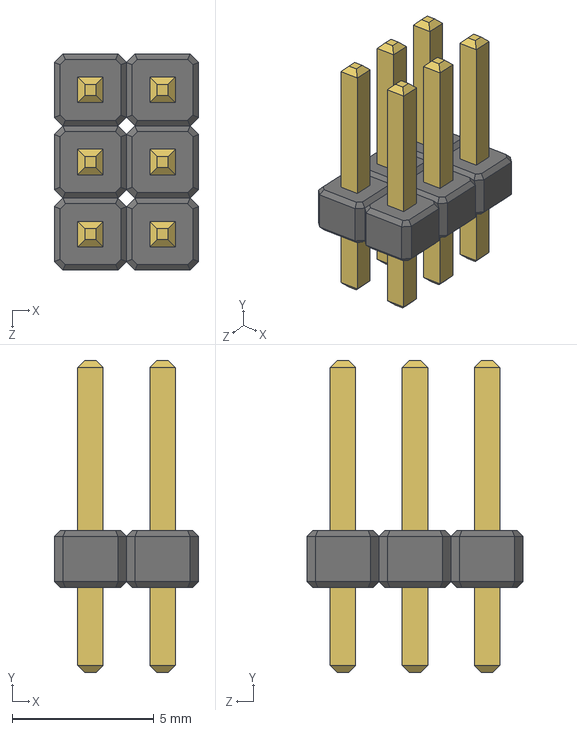
[picture p8: CAD file, 2021-01-07]
3D Files/hdr2x3.step
5.08 x 11.0 x 7.62 mm
