mokweri/EmbedUno/3D Files/ABM7.STEP

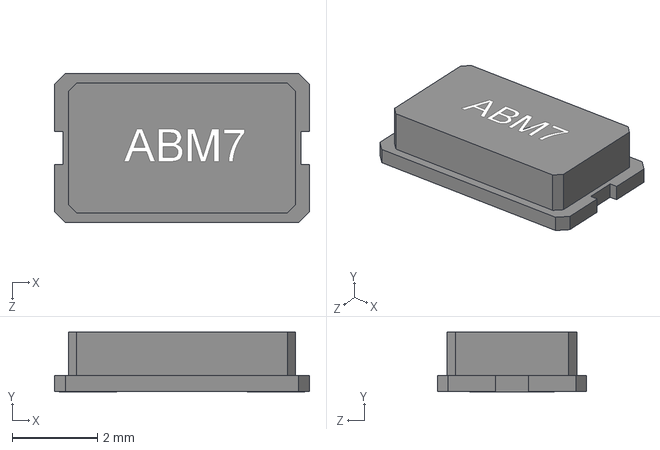
[picture p9: CAD file, 2021-01-07]
3D Files/ABM7.STEP
5.99 x 1.40 x 3.51 mm
