mokweri/EmbedUno/3D Files/User Library-FSM4JLH(1825910-5).step

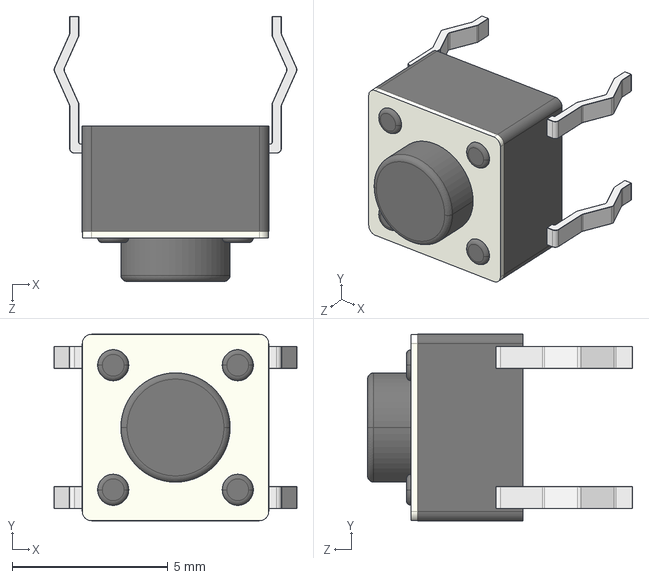
[picture p10: CAD file, 2021-01-07]
3D Files/User Library-FSM4JLH(1825910-5).step
7.80 x 5.99 x 8.51 mm
