mokweri/EmbedUno/3D Files/User Library-28 pin dip-1.step

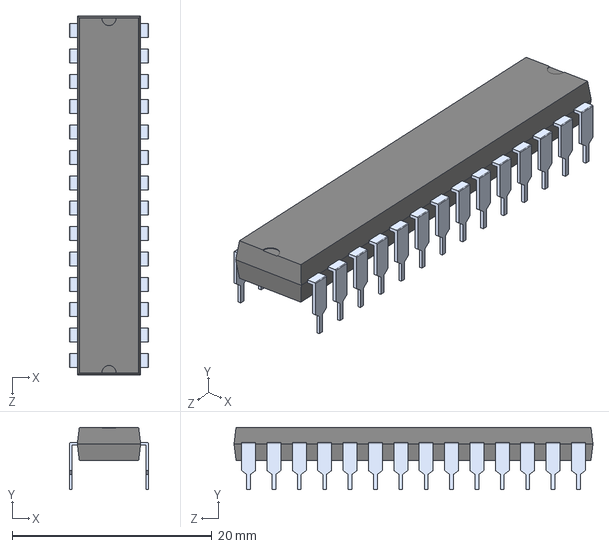
[picture p11: CAD file, 2021-01-07]
3D Files/User Library-28 pin dip-1.step
7.87 x 6.22 x 35.9 mm
