mokweri/EmbedUno/3D Files/capacitor size C.step

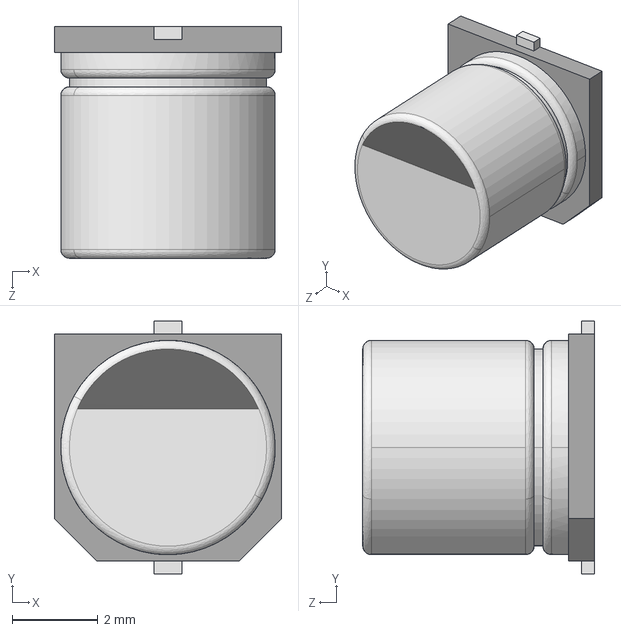
[picture p12: CAD file, 2021-01-07]
3D Files/capacitor size C.step
5.30 x 5.90 x 5.41 mm
