mokweri/EmbedUno/3D Files/LED SMD 0603 super red.step

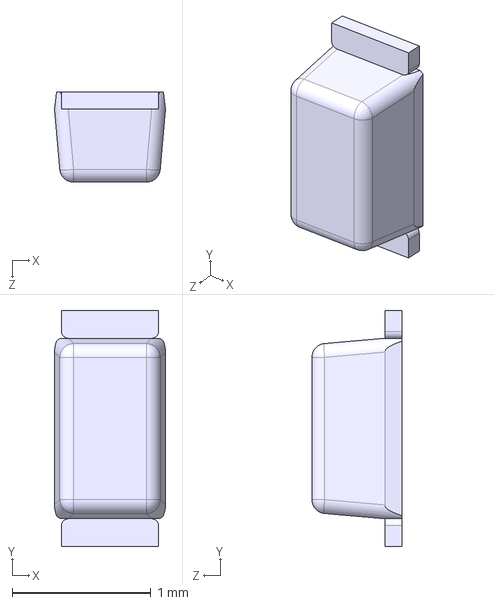
[picture p13: CAD file, 2021-01-07]
3D Files/LED SMD 0603 super red.step
0.8 x 1.70 x 0.65 mm
