mokweri/EmbedUno/3D Files/User Library-TPS73701DCQ.step

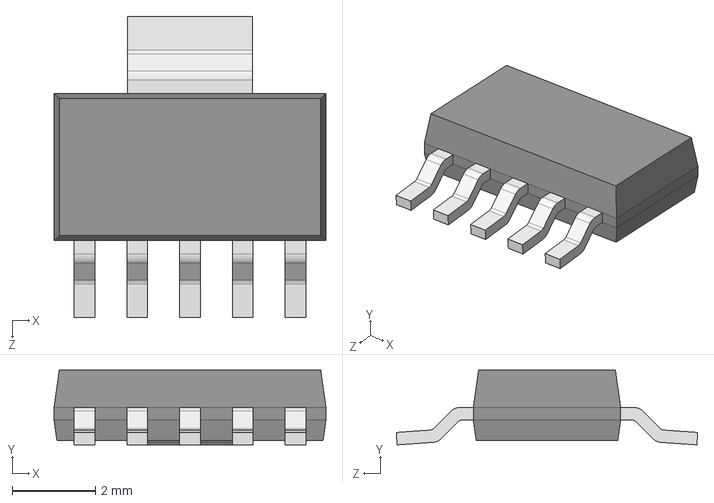
[picture p14: CAD file, 2021-01-07]
3D Files/User Library-TPS73701DCQ.step
6.55 x 1.80 x 7.26 mm
