mokweri/EmbedUno/3D Files/HDR_1x4_White.stp

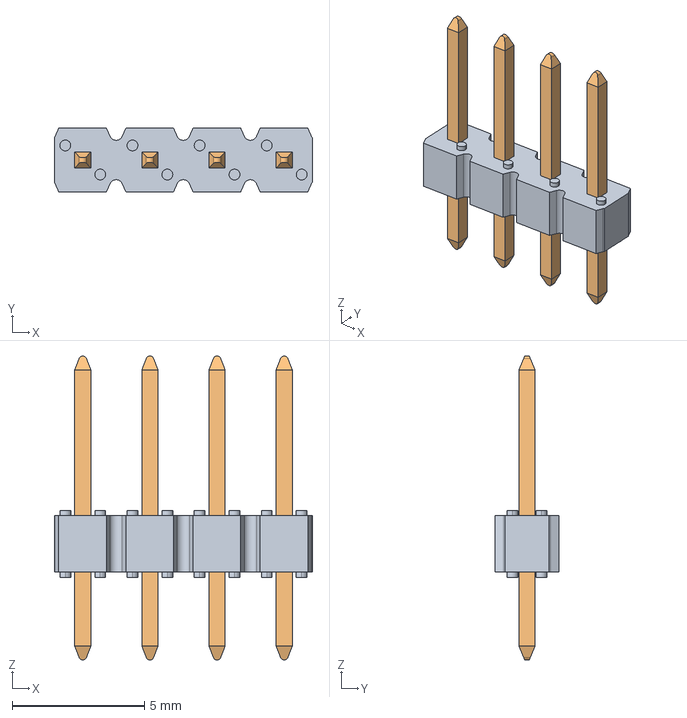
[picture p15: CAD file, 2021-01-07]
3D Files/HDR_1x4_White.stp
9.76 x 2.41 x 11.5 mm
