mokweri/EmbedUno/3D Files/HDR_1x3_White.stp

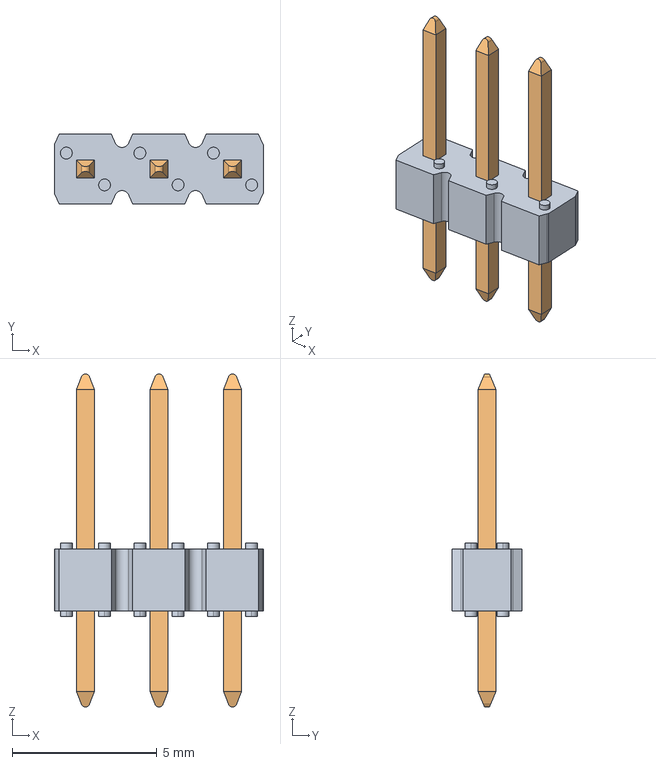
[picture p16: CAD file, 2021-01-07]
3D Files/HDR_1x3_White.stp
7.22 x 2.41 x 11.5 mm
77310_Y16 x 3
