mokweri/EmbedUno/3D Files/dil_socket.stp

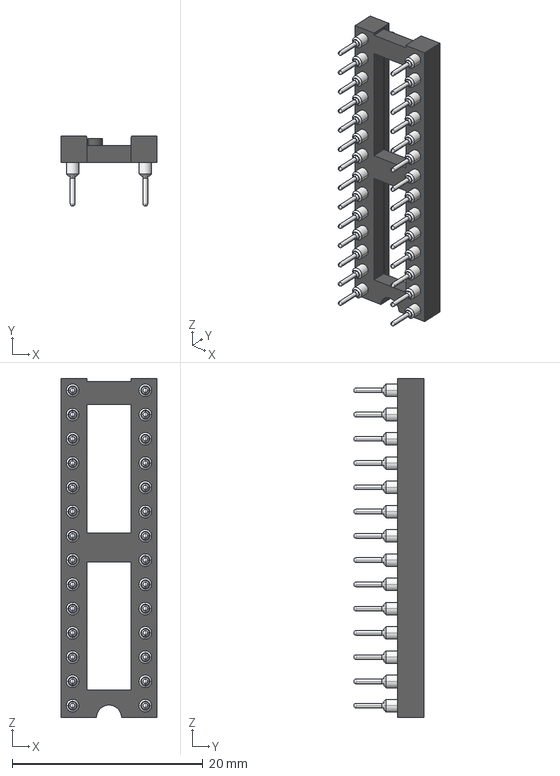
[picture p17: CAD file, 2021-01-07]
3D Files/dil_socket.stp
10.1 x 7.37 x 35.5 mm
