mokweri/EmbedUno/3D Files/User Library-tqfp32.step

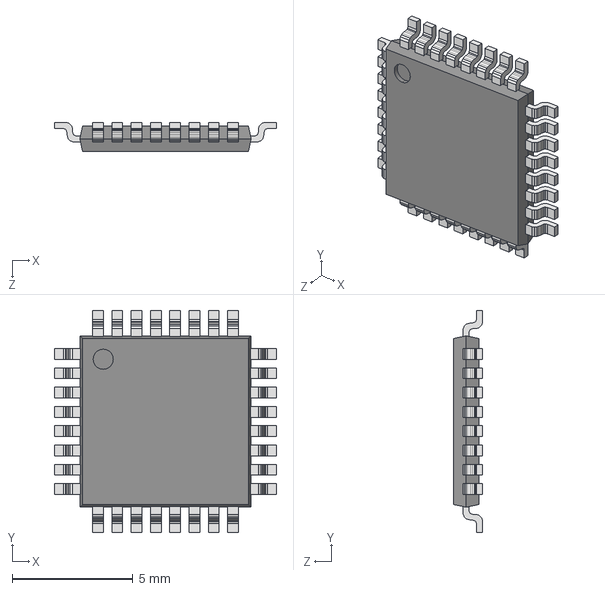
[picture p18: CAD file, 2021-01-07]
3D Files/User Library-tqfp32.step
9.20 x 9.20 x 1.20 mm
