mokweri/EmbedUno/3D Files/User Library-R-PDSO-G5.step

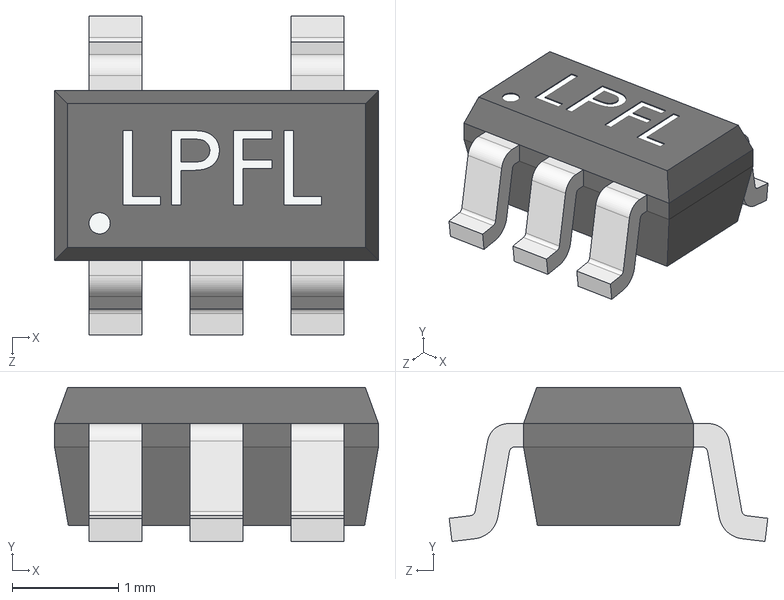
[picture p19: CAD file, 2021-01-07]
3D Files/User Library-R-PDSO-G5.step
3.05 x 1.45 x 3.00 mm
