mokweri/EmbedUno/3D Files/User Library-2x3 TH Pitch 2_54mm.STEP

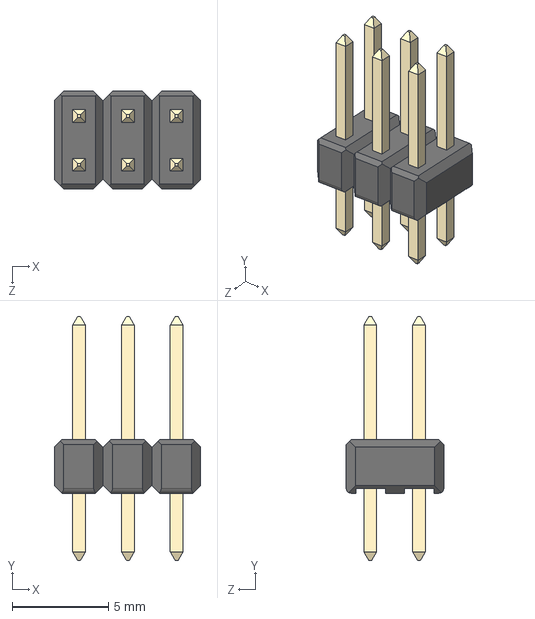
[picture p20: CAD file, 2021-01-07]
3D Files/User Library-2x3 TH Pitch 2_54mm.STEP
7.62 x 12.7 x 5.08 mm
header2x3
pin x 6
