mokweri/EmbedUno/(list of files, cad)

Other CAD files:
3D Files/m20-7820646_asm.stp
3D Files/m20-7820842_asm.stp
3D Files/m20-7821046_asm.stp
