mokweri/EmbedUno/DesignFiles/EmbedUno_V1I1/EmbedUno Library Check.pdf

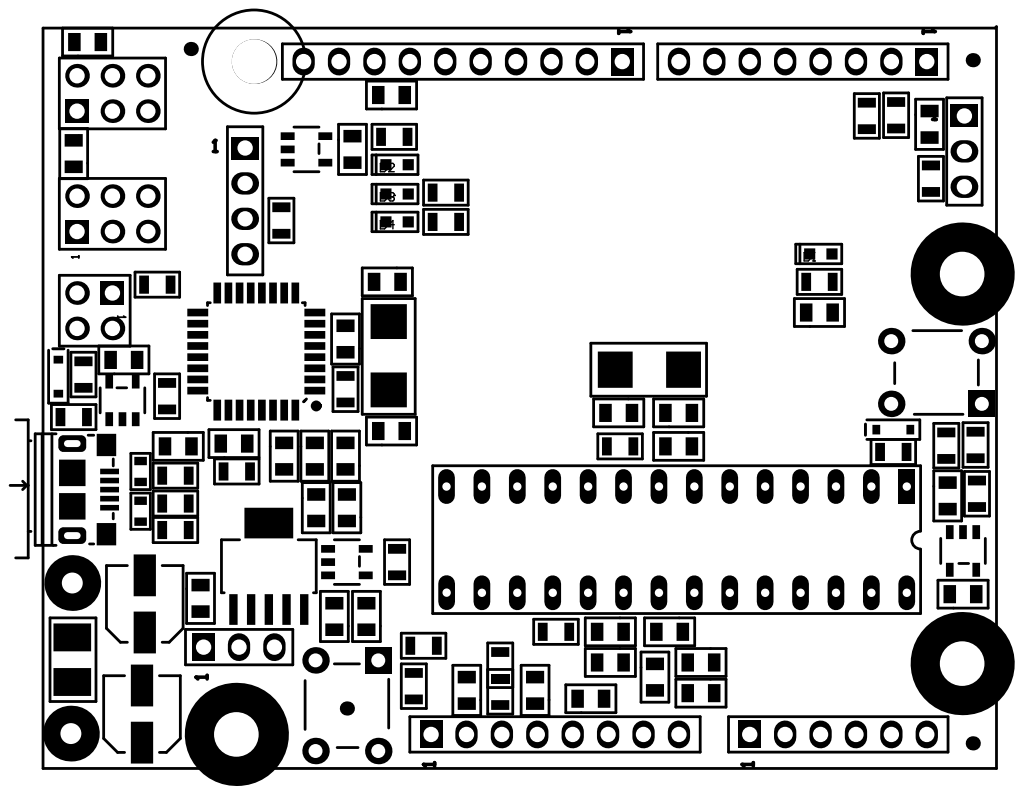
[picture p36: page 1]

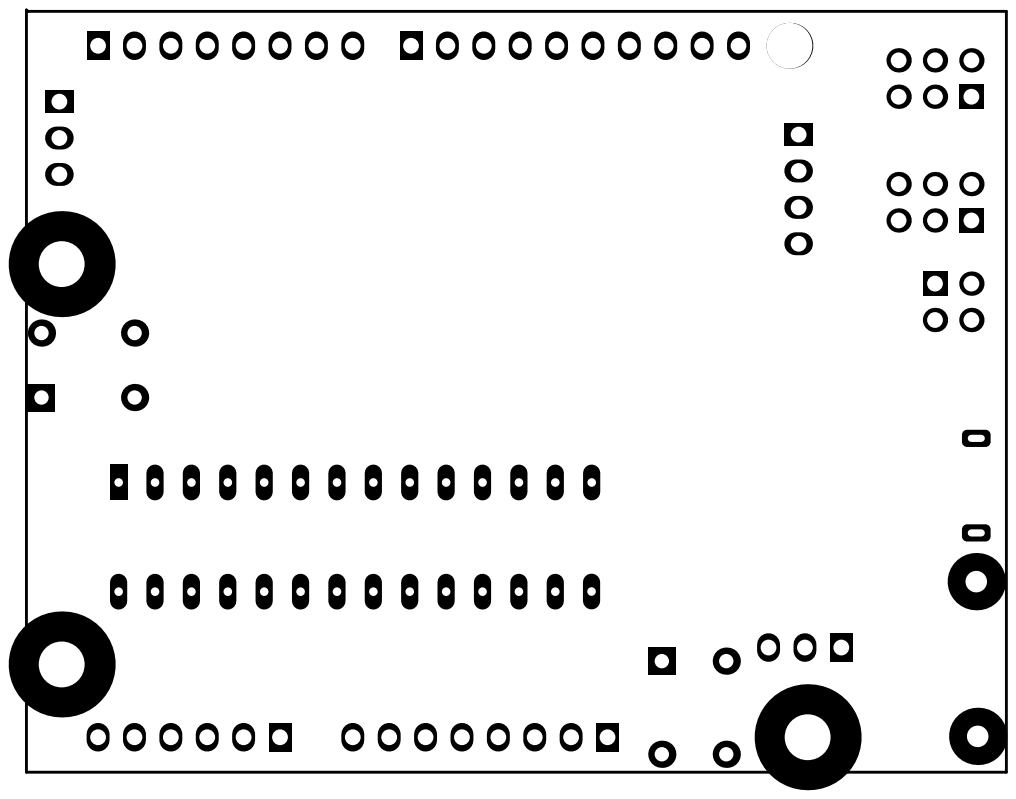
[picture p37: page 2]
