mokweri/EmbedUno/!Released Files/Step 2 - Board Assembly/Variant 1 - EmbedUno V1I1 - Fixed 5V/Top view Drawing - EmbedUno V1I1 - Fixed 5V.PDF

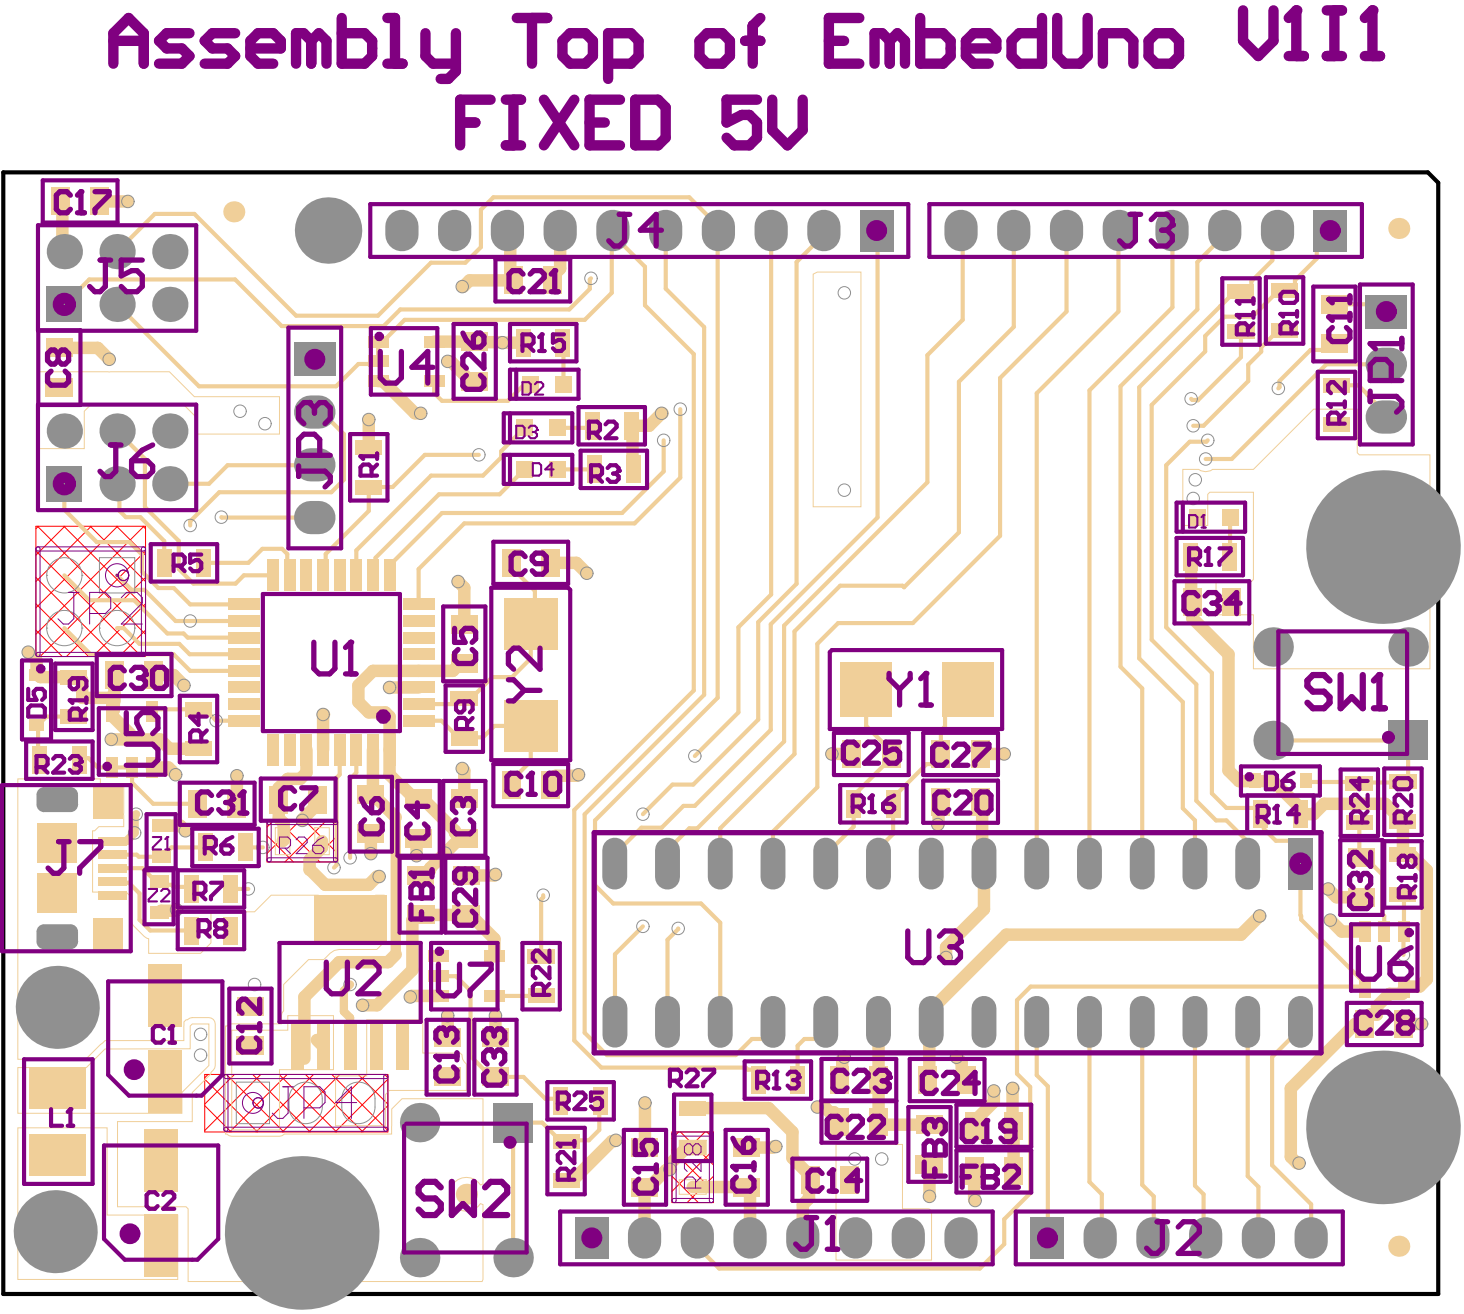
[picture p39: page 1]
