mokweri/EmbedUno/!Released Files/Step 2 - Board Assembly/Variant 2 - EmbedUno V1I1 - 5V and 3V3/Top view Drawing - EmbedUno V1I1 - 5V_3V3.PDF

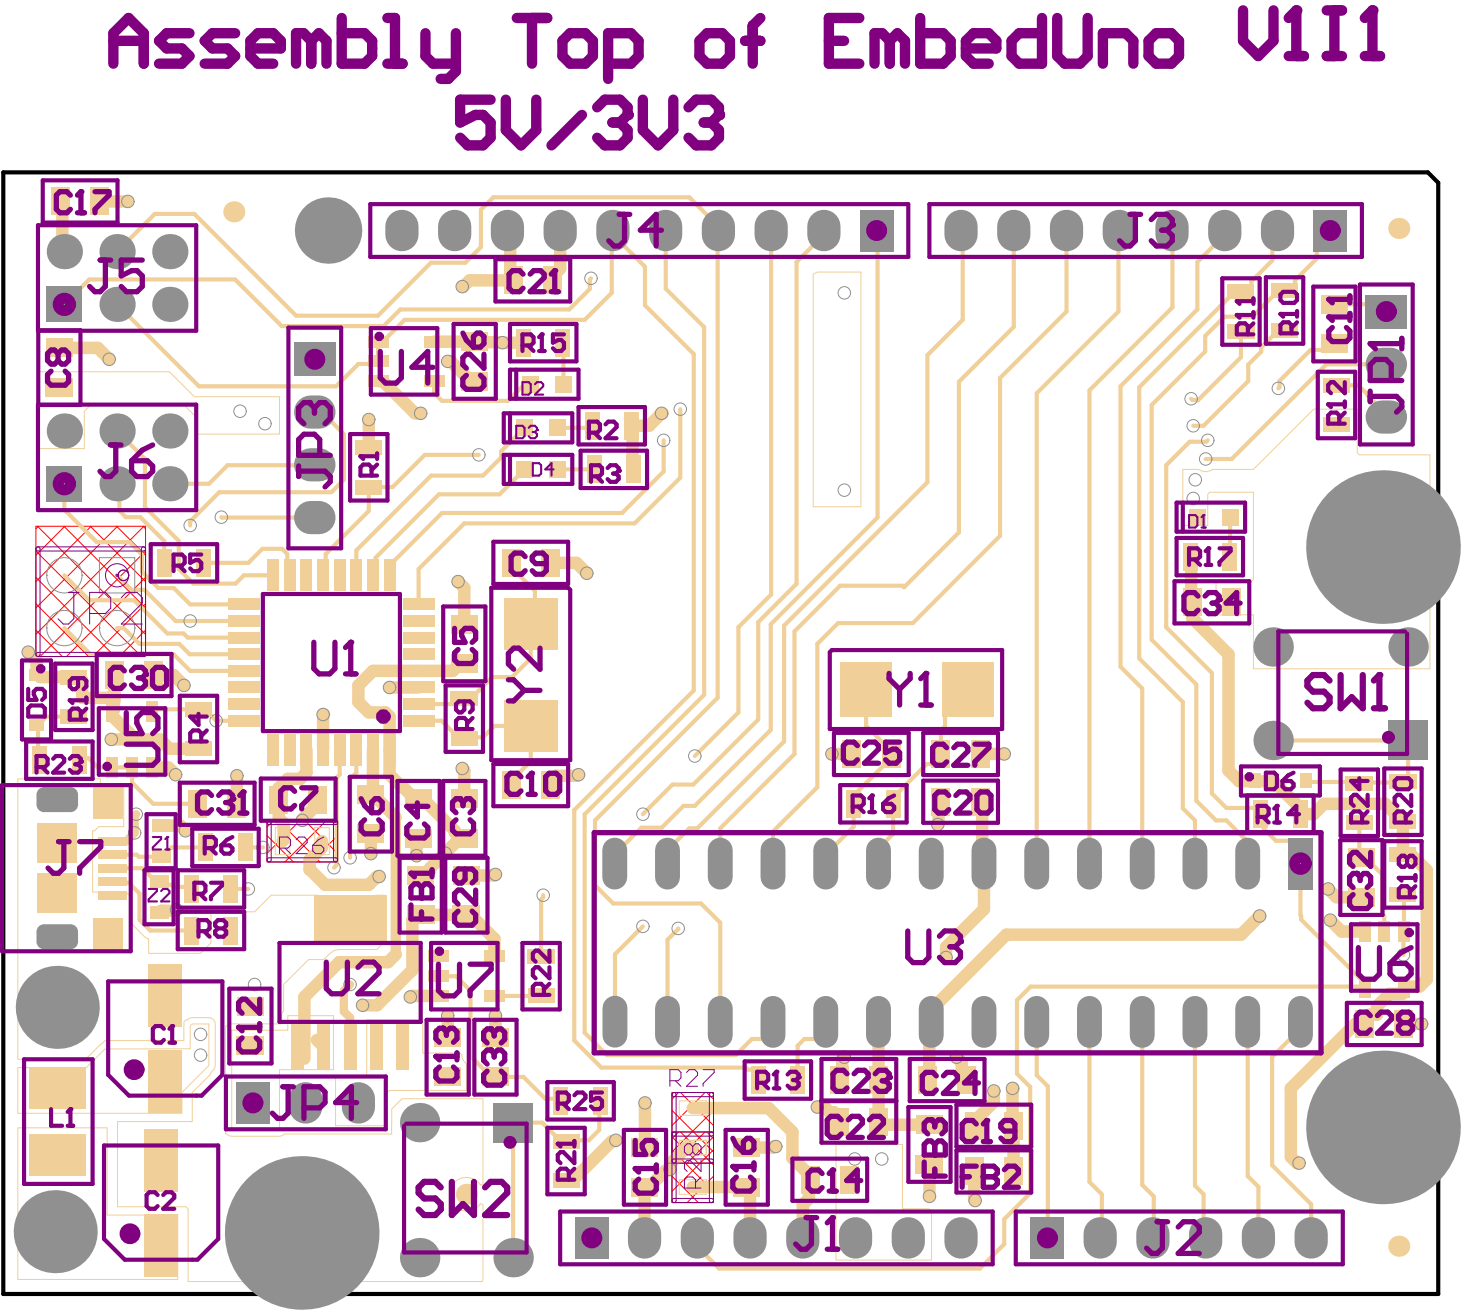
[picture p41: page 1]
