mokweri/EmbedUno/!Released Files/Step 2 - Board Assembly/Variant 1 - EmbedUno V1I1 - Fixed 5V/EmbedUno Mechanical Drawing.pdf

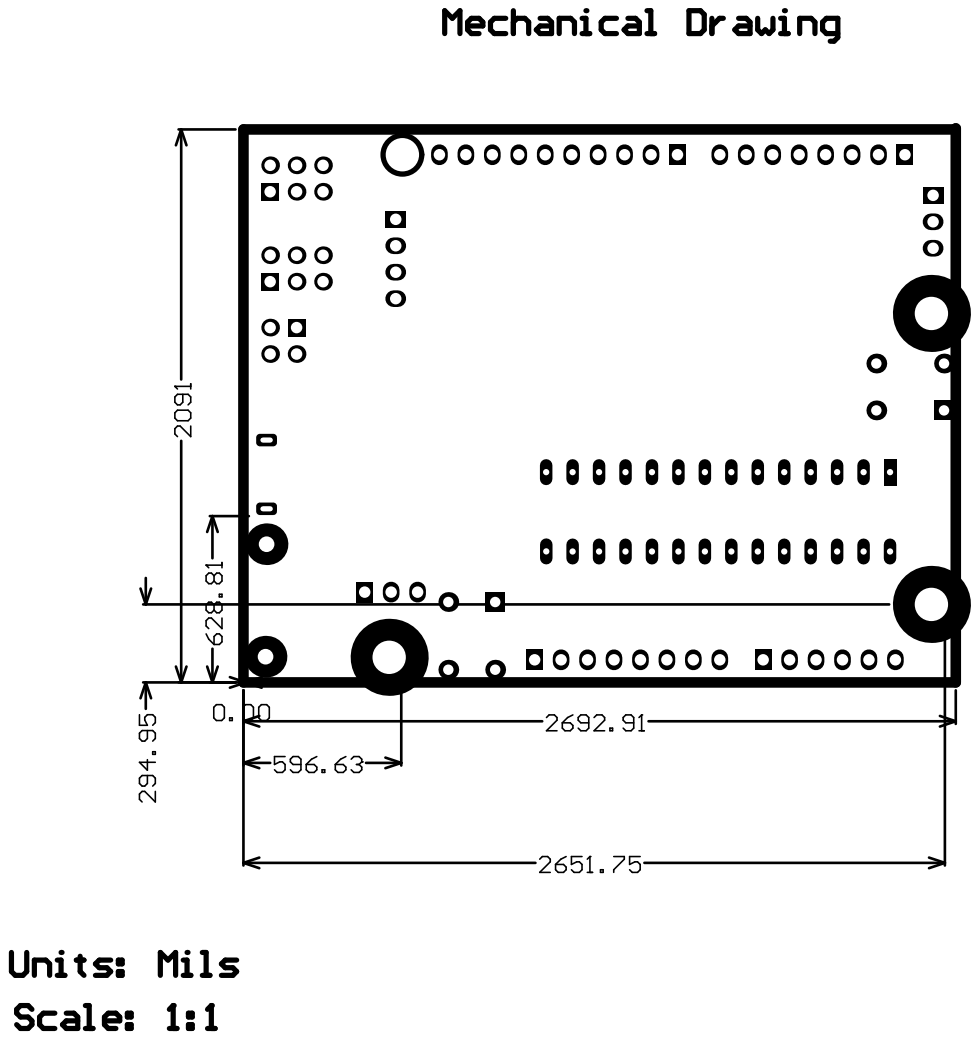
[picture p42: page 1]
