mokweri/EmbedUno/!Released Files/Step 1 - PCB Manufacturing/NC Drill Output/EmbedUno Dril Drawing.PDF

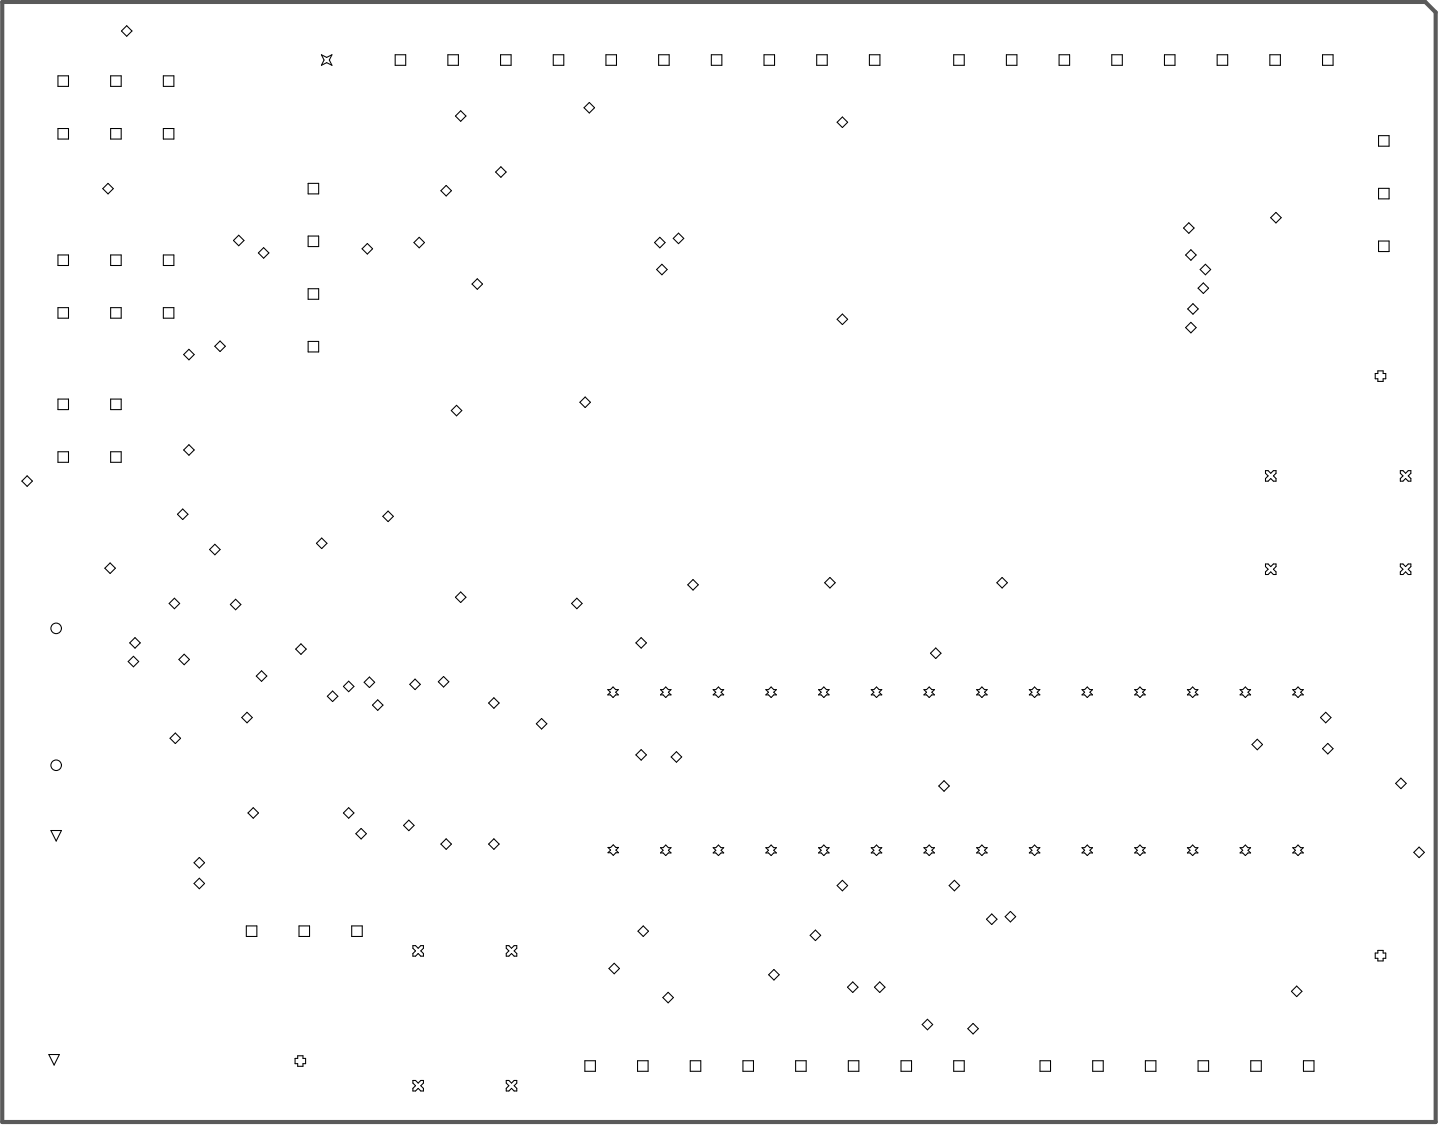
[picture p43: page 1]

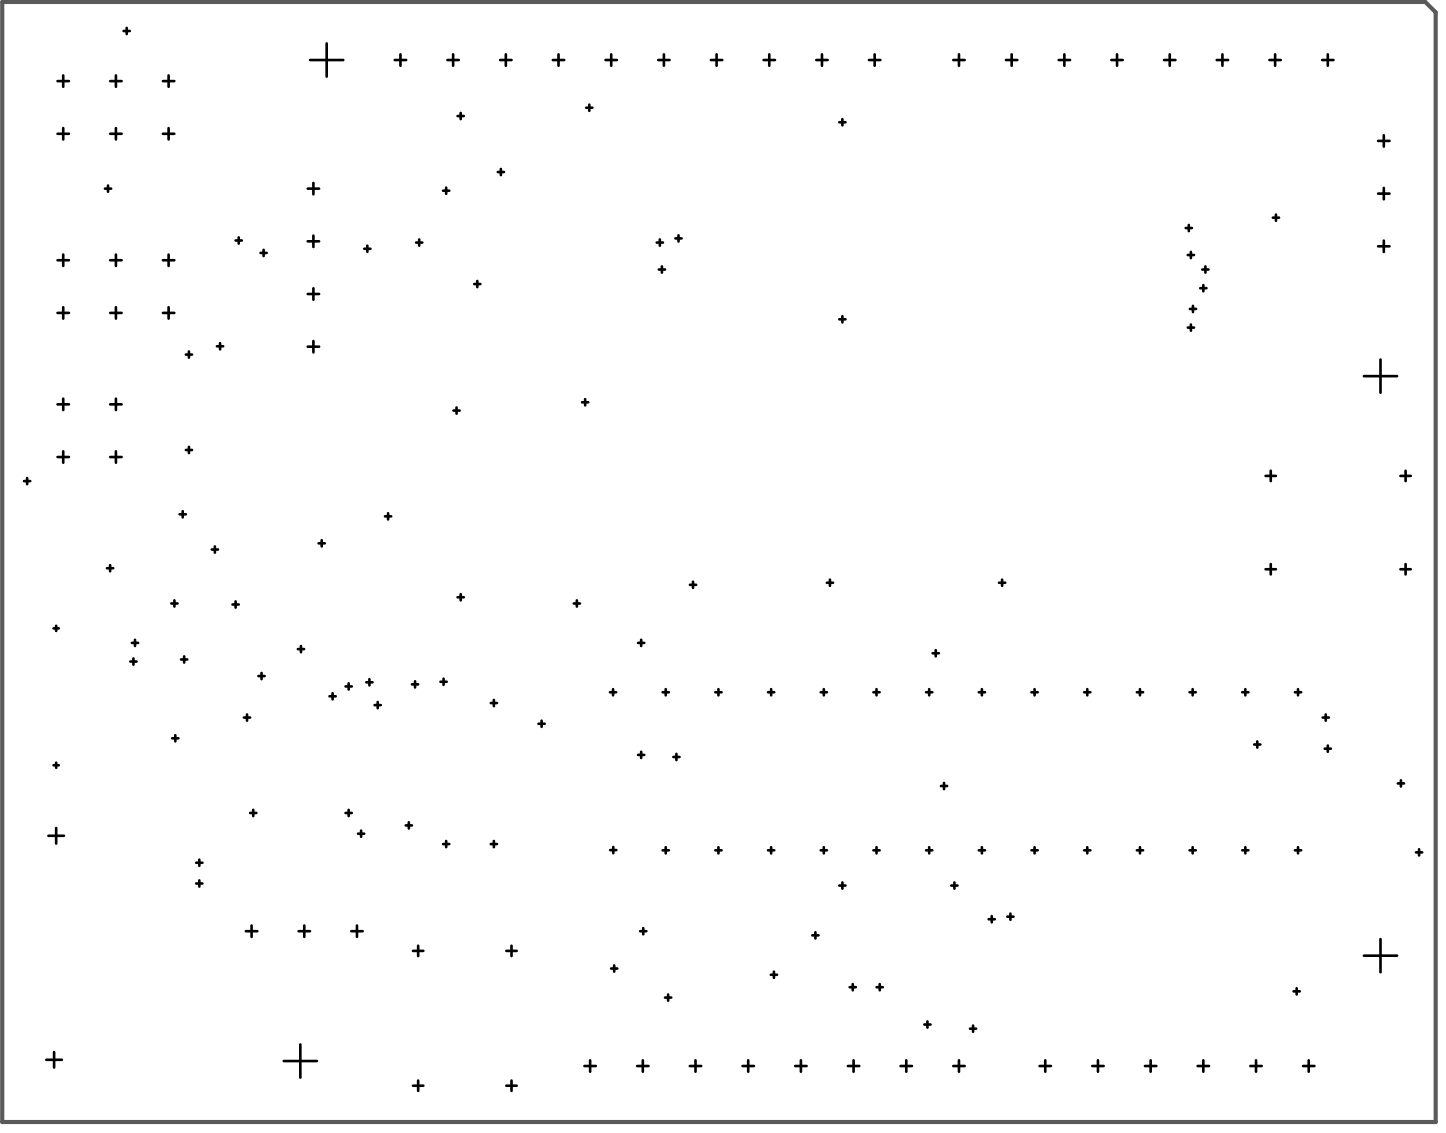
[picture p44: page 2]
