mokweri/EmbedUno/(list of files, drawings)

Other design files:
DesignFiles/EmbedUno_V1I1/[01] - COVER PAGE.SchDoc
DesignFiles/EmbedUno_V1I1/[02] - BLOCK DIAGRAM.SchDoc
DesignFiles/EmbedUno_V1I1/[03] - EmbedUno_Schematic.SchDoc
DesignFiles/EmbedUno_V1I1/[04] - REVISION HISTORY.SchDoc
DesignFiles/EmbedUno_V1I1/EmbedUno.SchDoc
DesignFiles/EmbedUno_V1I1/EmbedUno_V1I1.PcbLib
DesignFiles/EmbedUno_V1I1/EmbedUno_V1I1.PrjPcb
DesignFiles/EmbedUno_V1I1/EmbedUno_V1I1.SchLib
Templates/Templates/Schematic/28Pins_Project_V1I1 Project.SchDoc
Templates/Templates/Schematic/[01] - COVER PAGE.SchDoc
Templates/Templates/Schematic/[02] - BLOCK DIAGRAM.SchDoc
Templates/Templates/Schematic/[04] - REVISION HISTORY.SchDoc
