mokweri/EmbedUno/(commit log)

2021-01-07 Schematic update
    [[03] - EmbedUno_Schematic.SchDoc]
2021-01-07 mechanical assembly drawing
2021-01-08 Added Release files
    [BOM Purchasing - EmbedUno V1I1 - 5V_3V3.xls, BOM Purchasing - EmbedUno V1I1 - Fixed5V.xls, BOM Reference - EmbedUno_V1I1(5V_3V3).xlsx, BOM Reference - EmbedUno_V1I1(FIXED 5V).xlsx, BOM Reference FEDEVEL.xlsx, Componed Reference grouped BOM-EmbedUno_V1I1(5V_3V3).xls, Componed Reference grouped BOM-EmbedUno_V1I1(FIXED 5V).xls, EmbedUno BOM Purchasing-EmbedUno_V1I1.xls]
2021-01-08 added 3d image
    [EmbedUno_V1I1.PrjPcb]
2021-06-10 updated gitignore
    [EmbedUno_V1I1.PcbLib]
